adafruit/Adafruit-LT8912B-DSI-to-DVI-Converter-PCB/Adafruit LT8912B DSI to DVI Converter Rev B.brd

## EAGLE design Adafruit LT8912B DSI to DVI Converter Rev B.brd (2026-11-10)

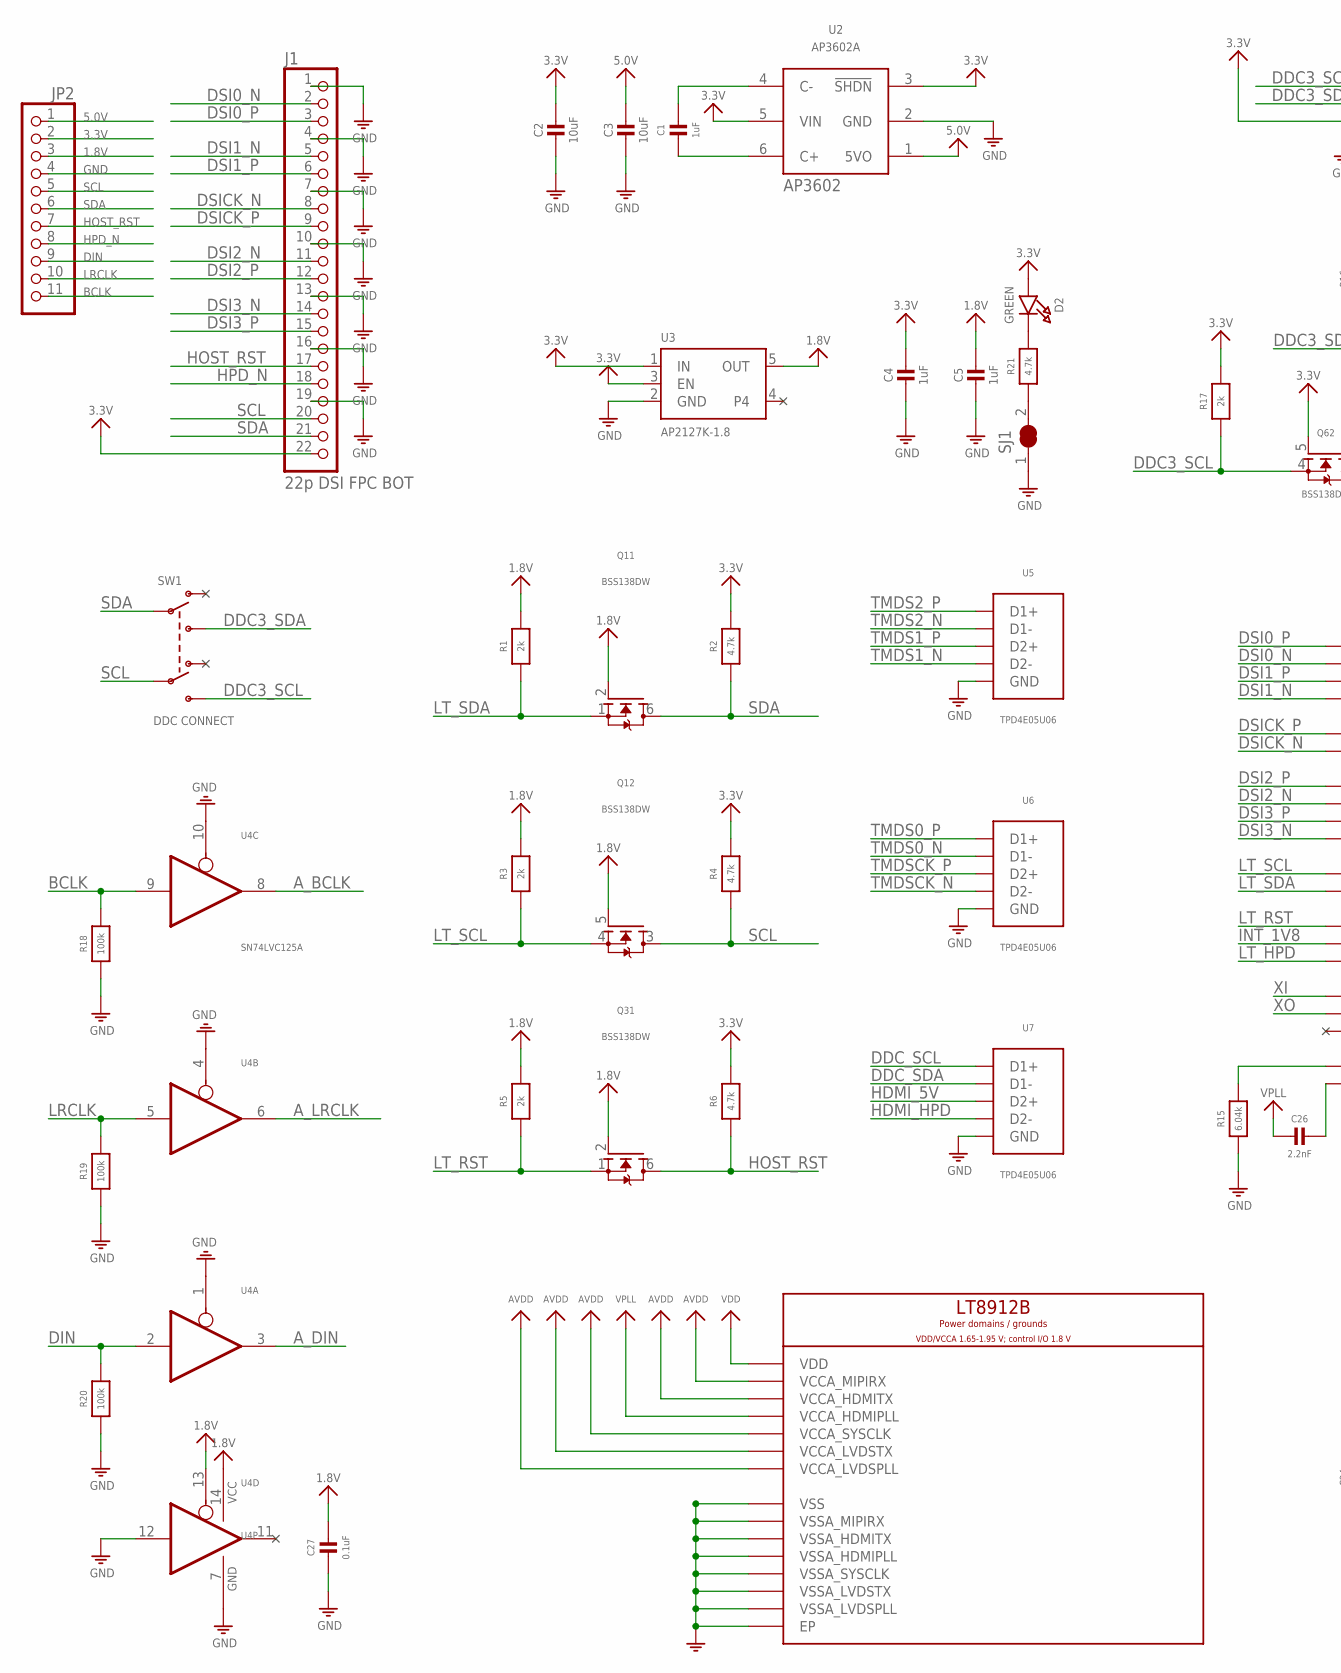
[picture p2: schematic Adafruit LT8912B DSI to DVI Converter Rev B.sch, part in row 1, column 1]

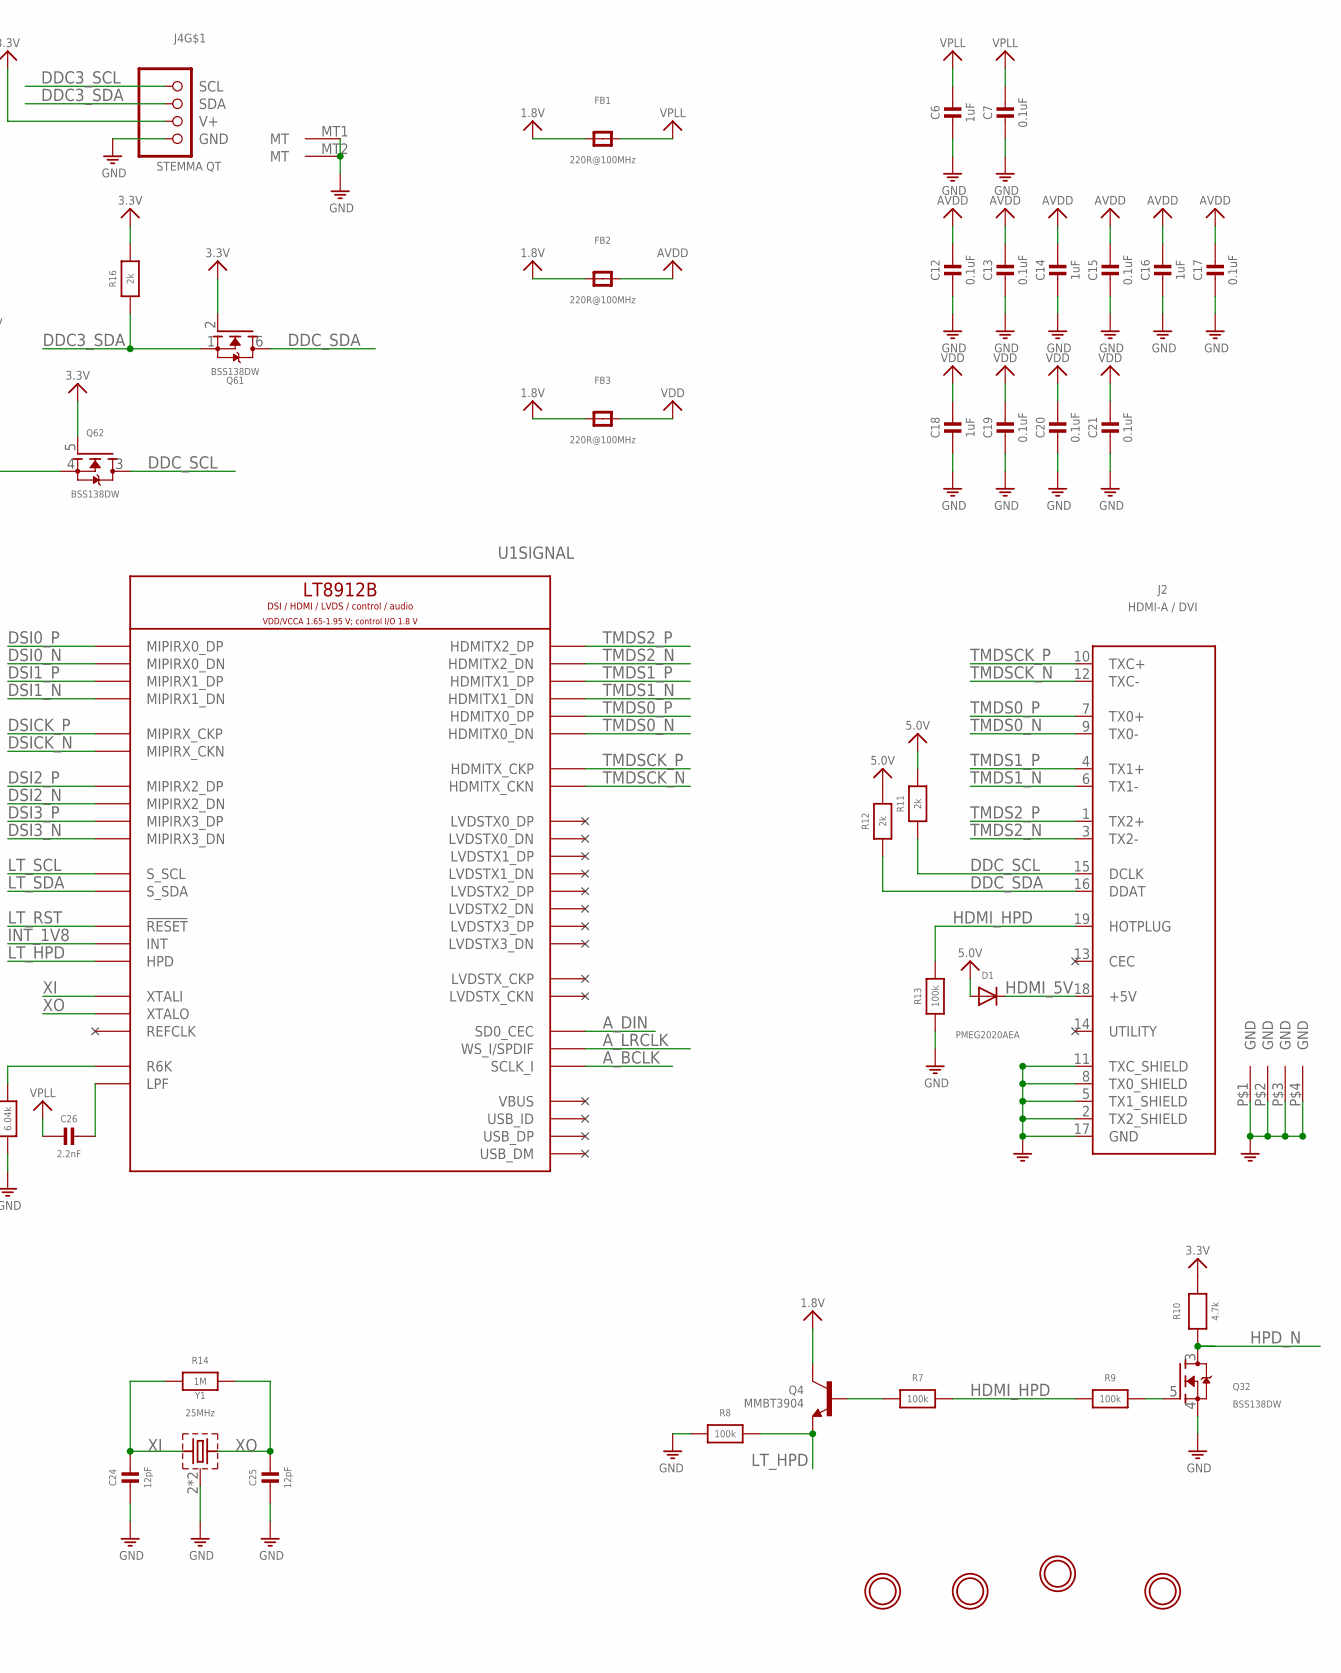
[picture p3: schematic Adafruit LT8912B DSI to DVI Converter Rev B.sch, part in row 1, column 2]

Parts:
C1, C4, C5, C6, C14, C16, C18: 1uF; 0603-NO
C2, C3: 10uF; 0805-NO
C7, C12, C13, C15, C17, C19, C20, C21, C27: 0.1uF; 0603-NO
C24, C25: 12pF; 0603-NO
C26: 2.2nF; 0603-NO
D1: PMEG2020AEA; SOD-323F; MPN PMEG2020AEA; LCSC C389354
D2: GREEN; CHIPLED_0603_NOOUTLINE
FB1, FB2, FB3: 220R@100MHz; 0603-NO
J1: 22p DSI FPC BOT; FPC_22PIN; MPN AFC01-S22FCA-00; LCSC C262668
J2: HDMI-A / DVI; HDMI_MOLEX_47151-0001; MPN HDMI-001 19PCBTP; LCSC C138388
J4: STEMMA QT; JST_SH4
JP2: HEADER-1X11; 1X11_ROUND
Q1, Q3, Q6: BSS138DW; SOT363; MPN BSS138DW-7-F; JLC_ROTATION 270
Q4: MMBT3904; SOT23-R
R1, R3, R5, R11, R12, R16, R17: 2k; 0603-NO
R2, R4, R6, R10, R21: 4.7k; 0603-NO
R7, R8, R9, R13, R18, R19, R20: 100k; 0603-NO
R14: 1M; 0603-NO
R15: 6.04k; 0603-NO
SJ1: SOLDERJUMPER_CLOSED; SOLDERJUMPER_CLOSEDWIRE
SW1: DDC CONNECT; EG1390; MPN MS-22C01-G010; LCSC C2837066
U1: LT8912B; QFN64_7.5X7.5_P04_EP62_LT8912B; MPN LT8912B; LCSC C2892102
U2: AP3602A; SOT23-6; MPN AP3602AKTR-G1; LCSC C460358
U3: AP2127K-1.8; SOT23-5; MPN AP2127K-1.8TRG1; LCSC C151375
U4: SN74LVC125A; TSSOP14; MPN SN74LVC125APWR; LCSC C7813
U5, U6, U7: TPD4E05U06; USON10_1X2.5_P05_TPD4E05U06; MPN TPD4E05U06DQAR; LCSC C138714
U$1, U$2, U$3, U$4: MOUNTINGHOLE2.5; MOUNTINGHOLE_2.5_PLATED
Y1: 25MHz; CRYSTAL_2X1.6; MPN Q22FA12800569; LCSC C193187

Connections:
1.8V: C5.1, C27.1, FB1.1, FB2.1, FB3.1, JP2.3, Q1.2 (G), Q1.5 (G), Q3.2 (G), Q4.3 (C), R1.2, R3.2, R5.2, U3.5 (OUT), U4.13 (OE), U4.14 (VCC)
3.3V: C2.1, C4.1, D2.A, J1.22, J4.2 (V+), JP2.2, Q6.2 (G), Q6.5 (G), R2.2, R4.2, R6.2, R10.2, R16.2, R17.2, U2.3 (!SHDN), U2.5 (VIN), U3.1 (IN), U3.3 (EN)
5.0V: C3.1, D1.A, JP2.1, R11.2, R12.2, U2.1 (5VO)
AVDD: C12.1, C13.1, C14.1, C15.1, C16.1, C17.1, FB2.2, U1.5 (VCCA_MIPIRX), U1.26 (VCCA_HDMITX), U1.41 (VCCA_LVDSTX), U1.50 (VCCA_SYSCLK), U1.52 (VCCA_LVDSPLL)
A_BCLK: U1.60 (SCLK_I), U4.8 (O)
A_DIN: U1.58 (SD0_CEC), U4.3 (O)
A_LRCLK: U1.59 (WS_I/SPDIF), U4.6 (O)
BCLK: JP2.11, R18.2, U4.9 (I)
BIAS: R15.2, U1.13 (R6K)
DDC3_SCL: J4.4 (SCL), Q6.4 (S), R17.1, SW1.S2
DDC3_SDA: J4.3 (SDA), Q6.1 (S), R16.1, SW1.S1
DDC_SCL: J2.15 (DCLK), Q6.3 (D), R11.1, U7.1 (D1+), U7.10 (D1+)
DDC_SDA: J2.16 (DDAT), Q6.6 (D), R12.1, U7.2 (D1-), U7.9 (D1-)
DIN: JP2.9, R20.2, U4.2 (I)
DSI0_N: J1.2, U1.2 (MIPIRX0_DN)
DSI0_P: J1.3, U1.1 (MIPIRX0_DP)
DSI1_N: J1.5, U1.4 (MIPIRX1_DN)
DSI1_P: J1.6, U1.3 (MIPIRX1_DP)
DSI2_N: J1.11, U1.10 (MIPIRX2_DN)
DSI2_P: J1.12, U1.9 (MIPIRX2_DP)
DSI3_N: J1.14, U1.12 (MIPIRX3_DN)
DSI3_P: J1.15, U1.11 (MIPIRX3_DP)
DSICK_N: J1.8, U1.8 (MIPIRX_CKN)
DSICK_P: J1.9, U1.7 (MIPIRX_CKP)
FLY_+: C1.2, U2.6 (C+)
FLY_-: C1.1, U2.4 (C-)
GND: C2.2, C3.2, C4.2, C5.2, C6.2, C7.2, C12.2, C13.2, C14.2, C15.2, C16.2, C17.2, C18.2, C19.2, C20.2, C21.2, C24.2, C25.2, C27.2, J1.1, J1.4, J1.7, J1.10, J1.13, J1.16, J1.19, J2.2 (TX2_SHIELD), J2.5 (TX1_SHIELD), J2.8 (TX0_SHIELD), J2.11 (TXC_SHIELD), J2.17 (GND), J2.P$1 (GND), J2.P$2 (GND), J2.P$3 (GND), J2.P$4 (GND), J4.1 (GND), J4.MT1 (MT), J4.MT2 (MT), JP2.4, Q3.4 (S), R8.1, R13.1, R15.1, R18.1, R19.1, R20.1, SJ1.1, U1.6 (VSSA_MIPIRX), U1.17 (VSS), U1.23 (VSSA_HDMITX), U1.29 (VSSA_HDMITX), U1.32 (VSS), U1.36 (VSSA_HDMIPLL), U1.42 (VSSA_LVDSTX), U1.49 (VSSA_SYSCLK), U1.51 (VSSA_LVDSPLL), U1.56 (VSS), U1.EP, U2.2 (GND), U3.2 (GND), U4.1 (OE), U4.4 (OE), U4.7 (GND), U4.10 (OE), U4.12 (I), U5.3 (GND), U5.8 (GND), U6.3 (GND), U6.8 (GND), U7.3 (GND), U7.8 (GND), Y1.2 (GND), Y1.4 (GND)
HDMI_5V: D1.C, J2.18 (+5V), U7.4 (D2+), U7.7 (D2+)
HDMI_HPD: J2.19 (HOTPLUG), R7.1, R9.1, R13.2, U7.5 (D2-), U7.6 (D2-)
HOST_RST: J1.17, JP2.7, Q3.6 (D), R6.1
HPD_BASE: Q4.1 (B), R7.2
HPD_HOST_B: Q3.5 (G), R9.2
HPD_N: J1.18, JP2.8, Q3.3 (D), R10.1
INT_1V8: U1.63 (INT)
LPF: C26.1, U1.35 (LPF)
LRCLK: JP2.10, R19.2, U4.5 (I)
LT_HPD: Q4.2 (E), R8.2, U1.14 (HPD)
LT_RST: Q3.1 (S), R5.1, U1.64 (!RESET)
LT_SCL: Q1.4 (S), R3.1, U1.62 (S_SCL)
LT_SDA: Q1.1 (S), R1.1, U1.61 (S_SDA)
unnamed: R21.1, SJ1.2
unnamed: D2.C, R21.2
SCL: J1.20, JP2.5, Q1.3 (D), R4.1, SW1.P2
SDA: J1.21, JP2.6, Q1.6 (D), R2.1, SW1.P1
TMDS0_N: J2.9 (TX0-), U1.24 (HDMITX0_DN), U6.2 (D1-), U6.9 (D1-)
TMDS0_P: J2.7 (TX0+), U1.25 (HDMITX0_DP), U6.1 (D1+), U6.10 (D1+)
TMDS1_N: J2.6 (TX1-), U1.27 (HDMITX1_DN), U5.5 (D2-), U5.6 (D2-)
TMDS1_P: J2.4 (TX1+), U1.28 (HDMITX1_DP), U5.4 (D2+), U5.7 (D2+)
TMDS2_N: J2.3 (TX2-), U1.30 (HDMITX2_DN), U5.2 (D1-), U5.9 (D1-)
TMDS2_P: J2.1 (TX2+), U1.31 (HDMITX2_DP), U5.1 (D1+), U5.10 (D1+)
TMDSCK_N: J2.12 (TXC-), U1.21 (HDMITX_CKN), U6.5 (D2-), U6.6 (D2-)
TMDSCK_P: J2.10 (TXC+), U1.22 (HDMITX_CKP), U6.4 (D2+), U6.7 (D2+)
VDD: C18.1, C19.1, C20.1, C21.1, FB3.2, U1.18 (VDD), U1.33 (VDD), U1.57 (VDD)
VPLL: C6.1, C7.1, C26.2, FB1.2, U1.34 (VCCA_HDMIPLL)
XI: C24.1, R14.1, U1.53 (XTALI), Y1.1
XO: C25.1, R14.2, U1.54 (XTALO), Y1.3 (2)

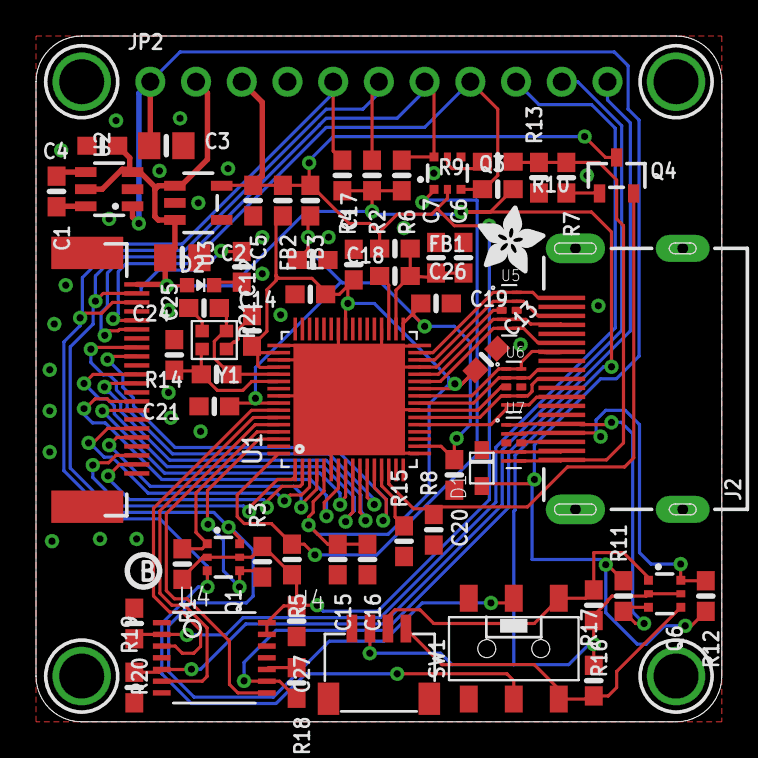
[picture p4: board Adafruit LT8912B DSI to DVI Converter Rev B.brd from above]

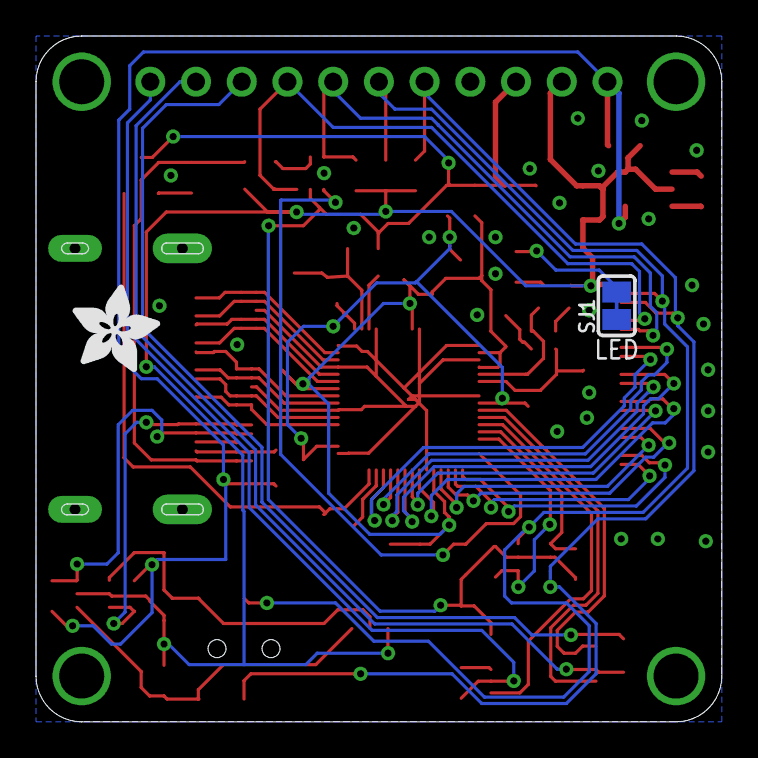
[picture p5: board Adafruit LT8912B DSI to DVI Converter Rev B.brd from below]

Board: 2 copper layers, 38.1 x 38.1 mm, 108 parts (18 on the bottom side), 55 nets.

Other parts of the board:
PLABEL0: PLABEL0
PLABEL1: PLABEL1
PLABEL2: PLABEL2
PLABEL3: PLABEL3
PLABEL4: PLABEL4
PLABEL5: PLABEL5
PLABEL6: PLABEL6
PLABEL7: PLABEL7
PLABEL8: PLABEL8
PLABEL9: PLABEL9
PLABEL10: PLABEL10
PLABEL11: PLABEL11
PLABEL12: PLABEL12
PLABEL13: PLABEL13
PLABEL14: PLABEL14
PLABEL15: PLABEL15
PLABEL16: PLABEL16
PLABEL17: PLABEL17
PLABEL18: PLABEL18
PLABEL19: PLABEL19
PLABEL20: PLABEL20
PLABEL21: PLABEL21
PLABEL22: PLABEL22
PLABEL23: PLABEL23
PLABEL24: PLABEL24
PLABEL25: PLABEL25
PLABEL26: PLABEL26
PLABEL27: PLABEL27
PLABEL28: PLABEL28
PLABEL29: PLABEL29
PLABEL30: PLABEL30
PLABEL31: PLABEL31
PLABEL32: PLABEL32
PLABEL33: PLABEL33
PLABEL34: PLABEL34
PLABEL35: PLABEL35
U$5: ADAFRUIT_3.5MM
U$6: PCBFEAT-REV-040
U$7: ADAFRUIT_5MM
