adafruit/Adafruit-LT8912B-DSI-to-DVI-Converter-PCB/(notices)

Notices in the files:
parts and their libraries:
microbuilder: This work is placed in the public domain, and may be freely used for commercial and non-commercial work with the following conditions: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
